pcace/Tailwind/_documentation/3DPrints/readme.md

files from: https://endless-sphere.com/sphere/threads/opensource-ampler.111419/
