pcace/Tailwind/_documentation/Ampler Controller BAC500/Readme.md

The Ampler (at least Curt) uses a BAC-500 esc with a custom daughterboard which handles bluetooth, on/off swiching and 5V BEC
