pcace/Tailwind/_documentation/Arduino/Readme.md

vesc files from https://endless-sphere.com/sphere/threads/opensource-ampler.111419/#post-1712720
