pcace/Tailwind/_documentation/Charging port/Readme.md

the charging port (2018 Ampler Curt) has 6 PIns:

- 2 High Voltage charging pins, directly connected to the Battery BMS.
- GND and +5 Volt directly to Ampler Daughterboard (see readme.md in Ampler Controller BAC500)
- RX and TX to the BAC500 Esc. possibly for maintenance / support / reprogramming (?) see BAC500 for datasheets

Pins from the charging port to BEC500: 

BLUE        PIN20   RS485-TX
YELLOW      PIN19   RS485-RX

STECKER zum AN AUS SCHALTER:
gehen nur auf das ampler daugther board
