pcace/Tailwind/_documentation/TorqueSensor/Torque Sensor.md

The throttle sensor needs >7V to operate the torque sensor. a simple stepup converter does the trick!

Stecker vom Tretlager sensor, kabelfarben: 

ORANGE, leicht bräunlich,   pin14,  "Throttle Sig" (torque)
WEIß^                   ,   pin13,  "+12V"
BRAUN                       Pin9,   "PFS"
GRüN                        pin12,  "CRUISE"
SCHWARZ,                    PIN16,  "GND"
