pcace/Tailwind/_documentation/Ampler Controller BAC500/files/1696029982506.png

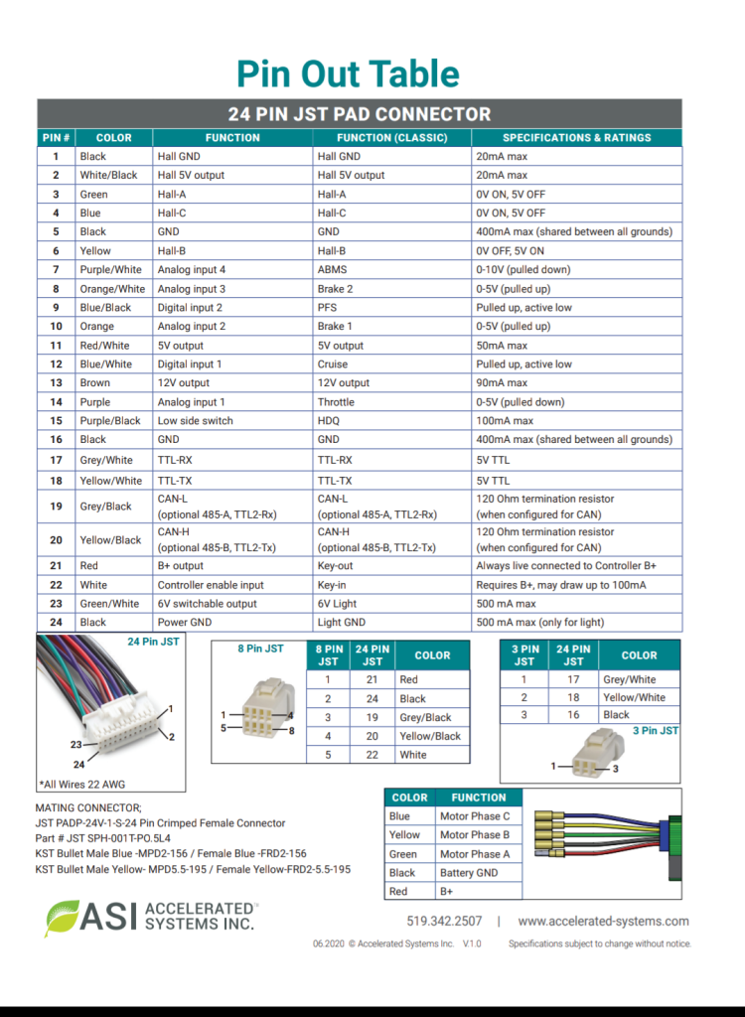
_documentation/Ampler Controller BAC500/files/1696029982506.png
