pcace/Tailwind/_documentation/Ampler Controller BAC500/files/1696030157137.png

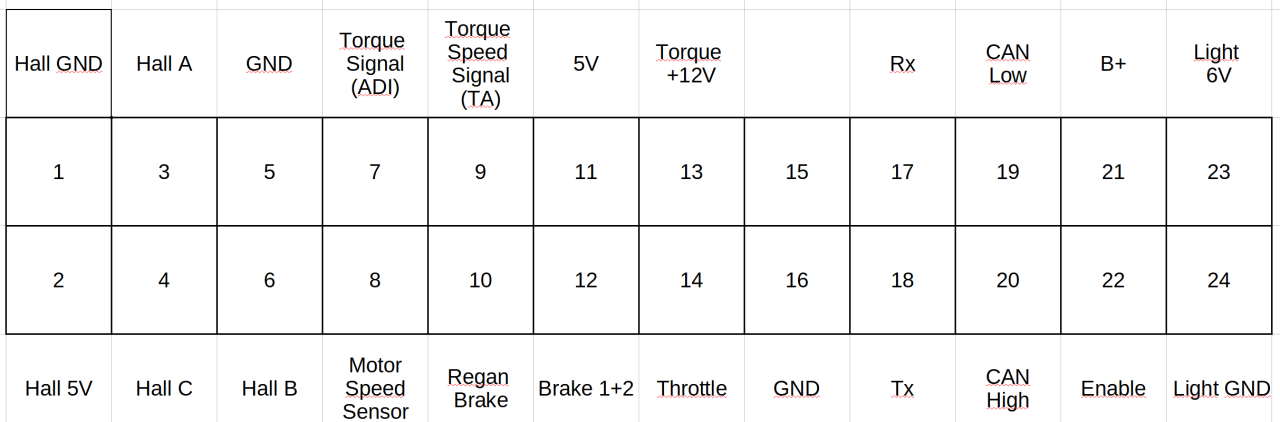
_documentation/Ampler Controller BAC500/files/1696030157137.png
