pcace/Tailwind/_documentation/Ampler Controller BAC500/files/IMG_7743.jpeg

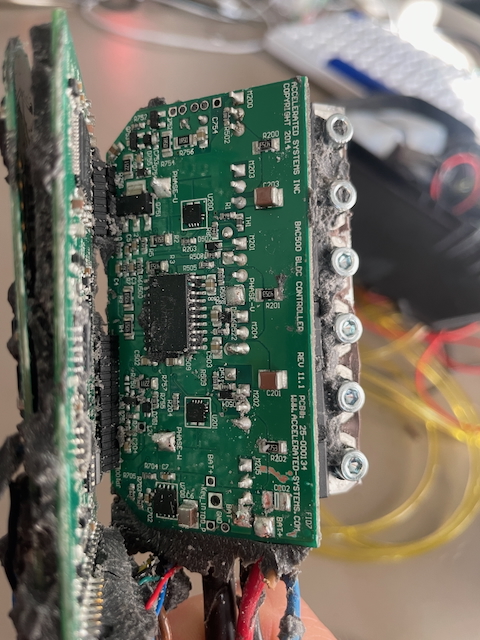
_documentation/Ampler Controller BAC500/files/IMG_7743.jpeg
