pcace/Tailwind/_documentation/Ampler Controller BAC500/files/PXL_20220623_150640996.PORTRAIT.jpg

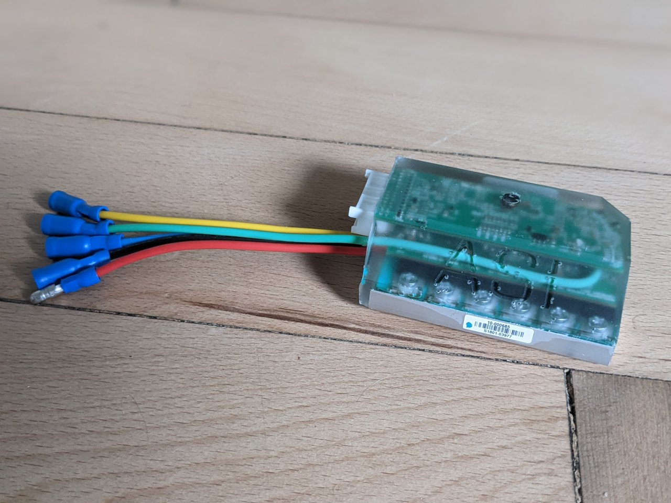
_documentation/Ampler Controller BAC500/files/PXL_20220623_150640996.PORTRAIT.jpg
