pcace/Tailwind/_documentation/Images/configurator-curt-matte-black-belt-0-carrier.jpg

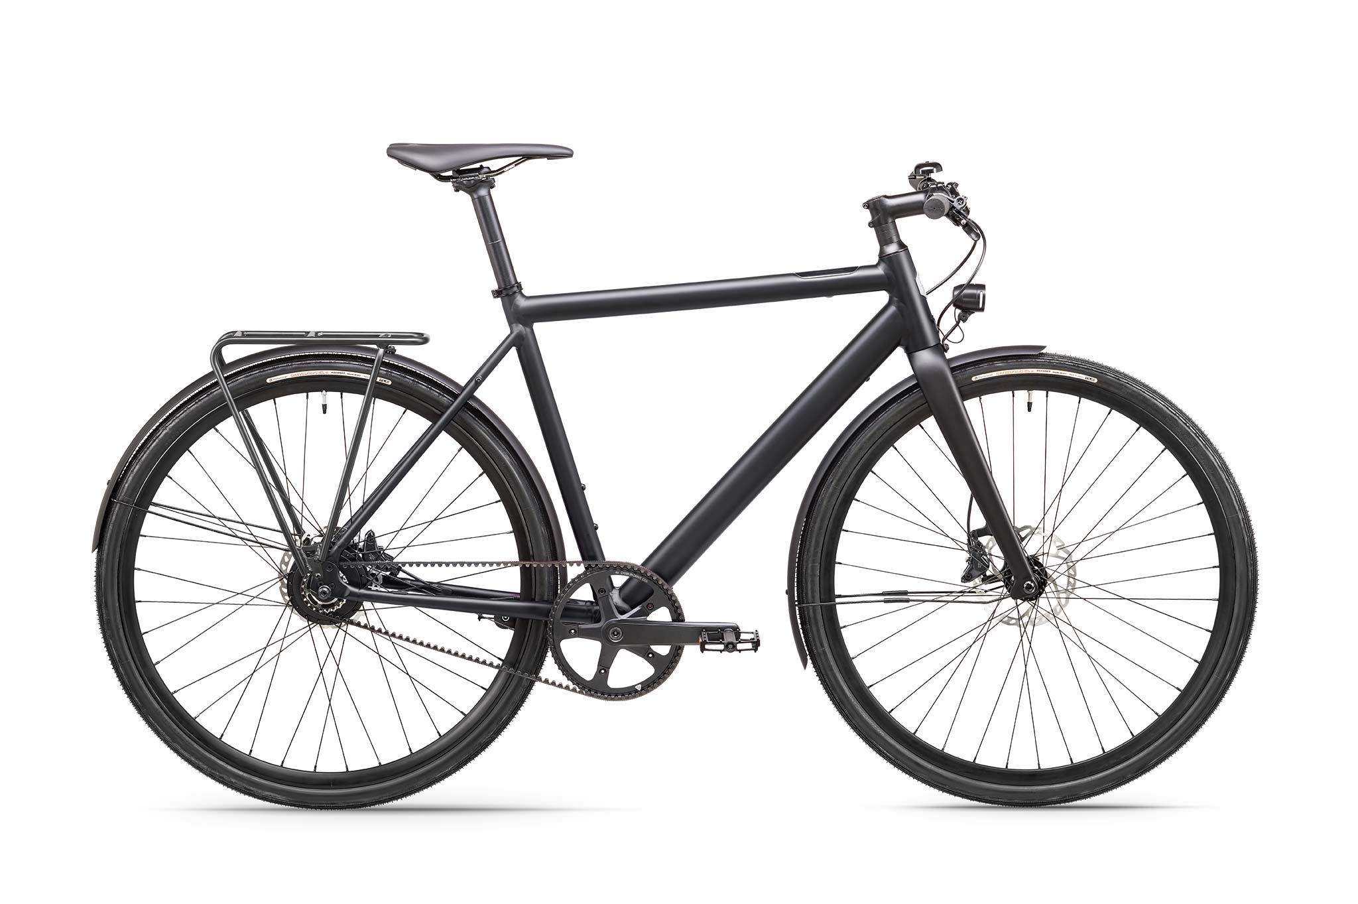
_documentation/Images/configurator-curt-matte-black-belt-0-carrier.jpg
