pcace/Tailwind/_documentation/Motor/files/1/01.jpg

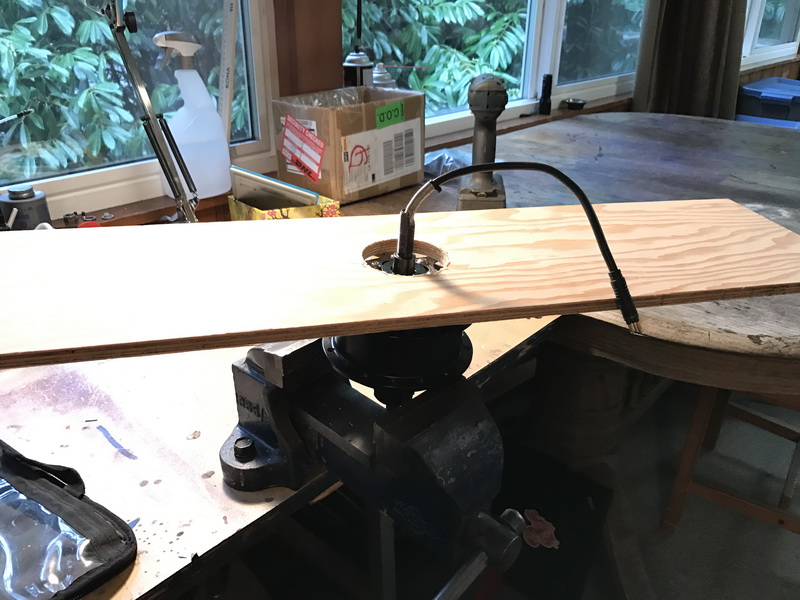
_documentation/Motor/files/1/01.jpg
