pcace/Tailwind/_documentation/Motor/files/1/02.jpg

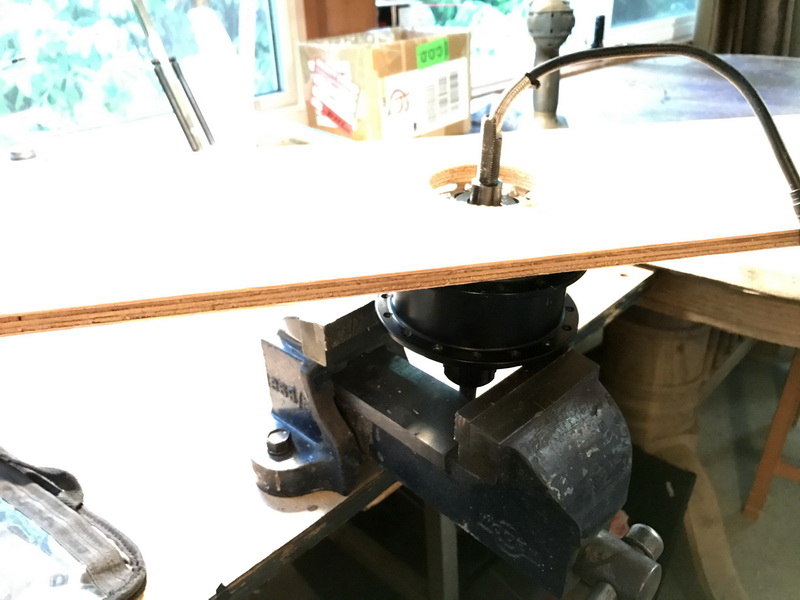
_documentation/Motor/files/1/02.jpg
