pcace/Tailwind/_documentation/Motor/files/1/03.jpg

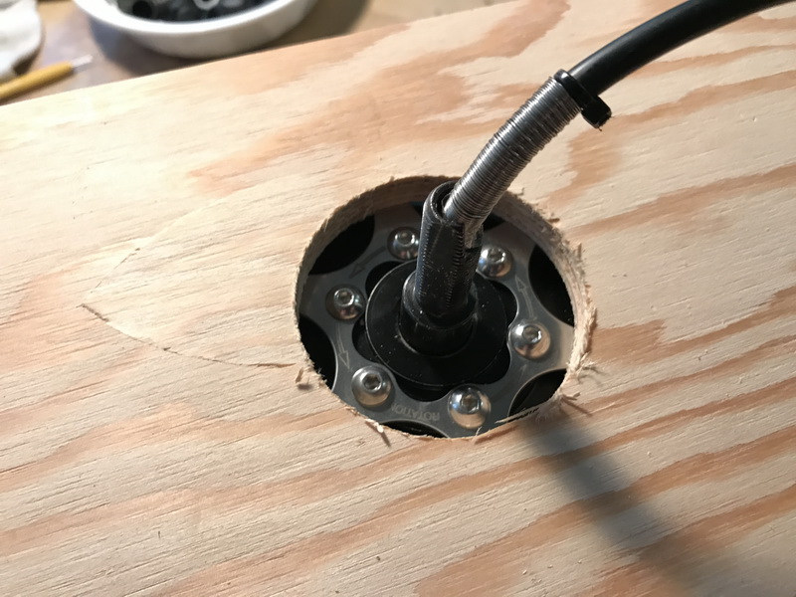
_documentation/Motor/files/1/03.jpg
