pcace/Tailwind/_documentation/Motor/files/1/04.jpg

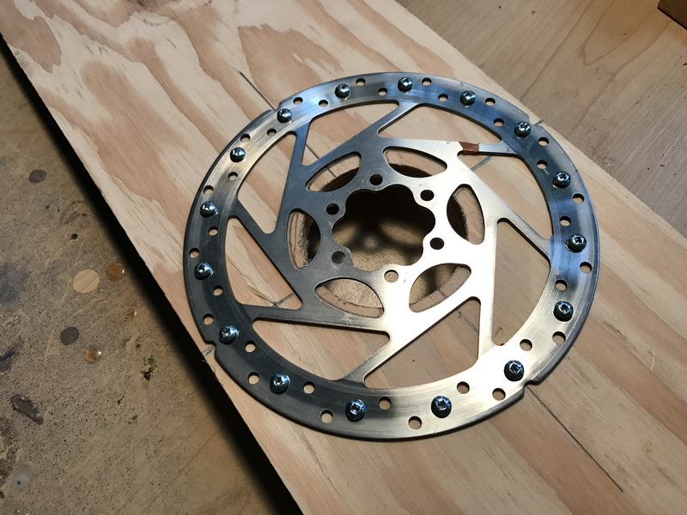
_documentation/Motor/files/1/04.jpg
