pcace/Tailwind/_documentation/Motor/files/1/05.jpg

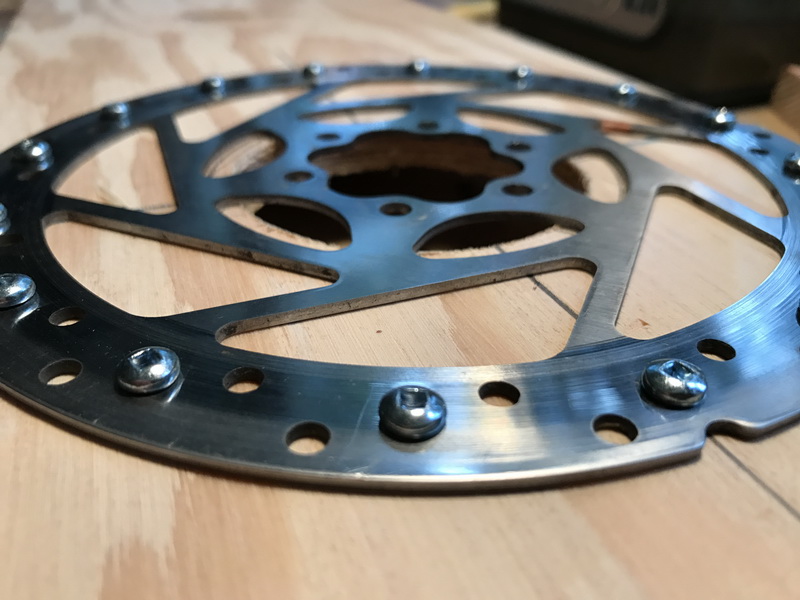
_documentation/Motor/files/1/05.jpg
