pcace/Tailwind/_documentation/Motor/files/1/06.jpg

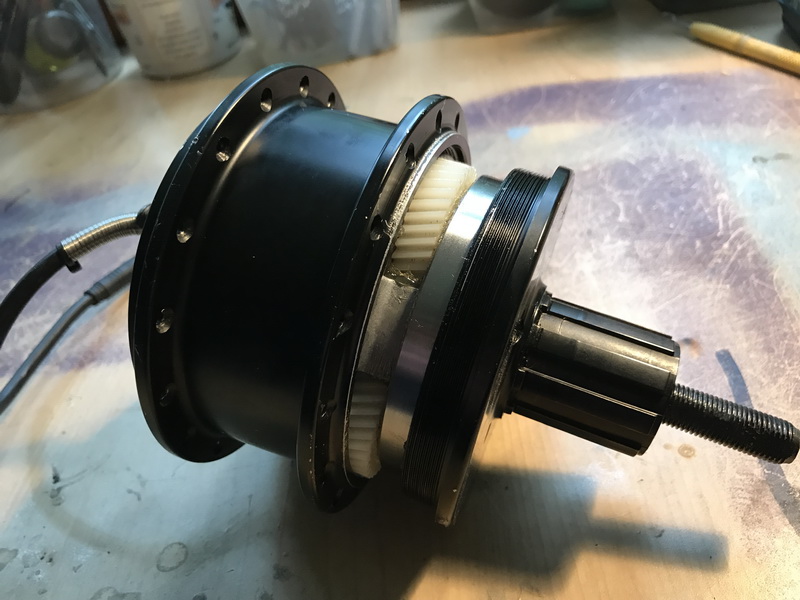
_documentation/Motor/files/1/06.jpg
