pcace/Tailwind/_documentation/Motor/files/1/07.jpg

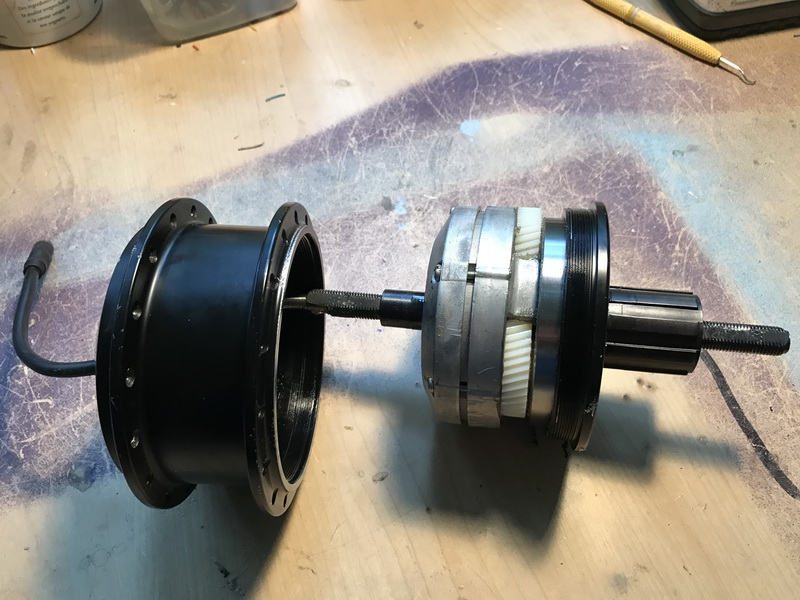
_documentation/Motor/files/1/07.jpg
