pcace/Tailwind/_documentation/Motor/files/1/08.jpg

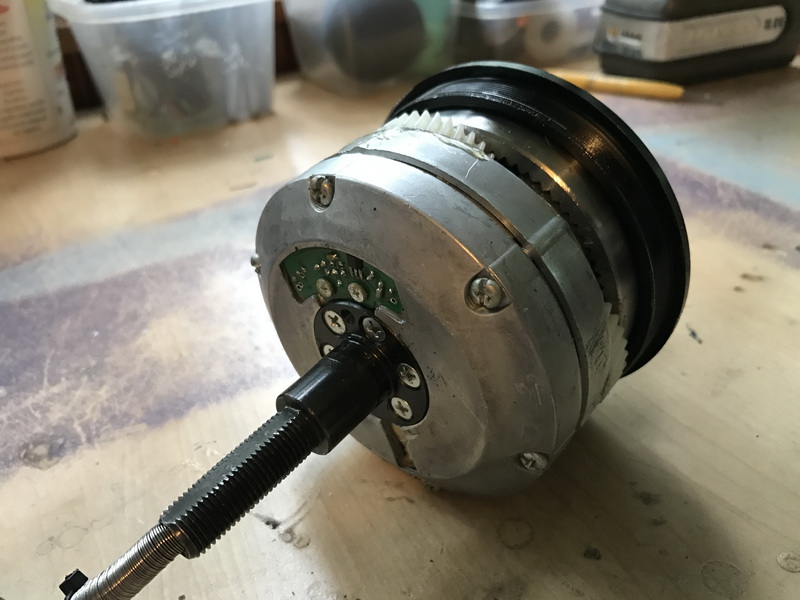
_documentation/Motor/files/1/08.jpg
