pcace/Tailwind/_documentation/Motor/files/1/09.jpg

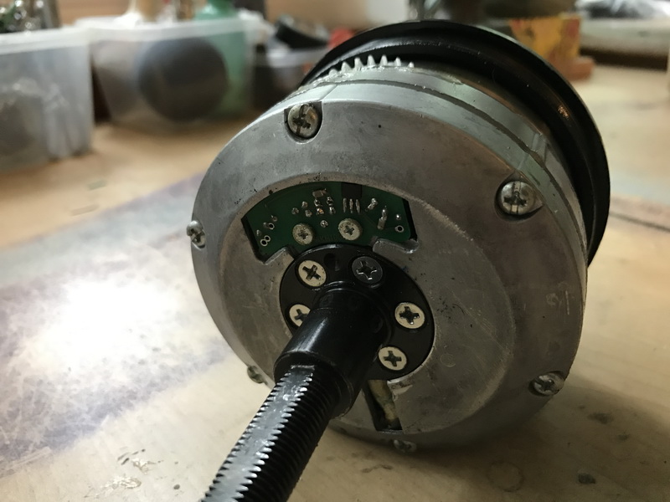
_documentation/Motor/files/1/09.jpg
