pcace/Tailwind/_documentation/Motor/files/1/10.jpg

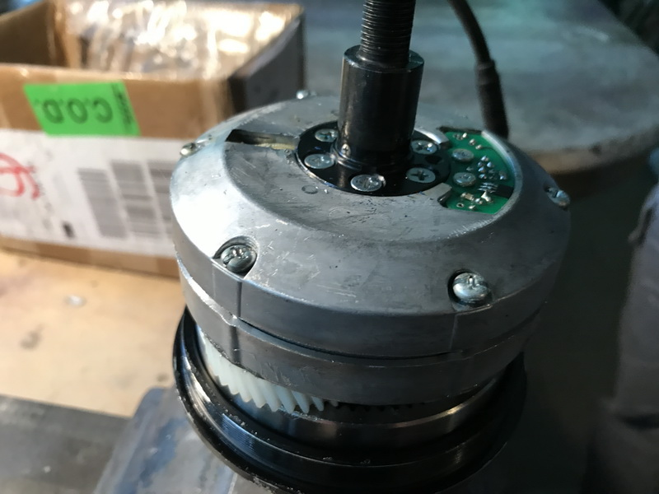
_documentation/Motor/files/1/10.jpg
