pcace/Tailwind/_documentation/Motor/files/1/11.jpg

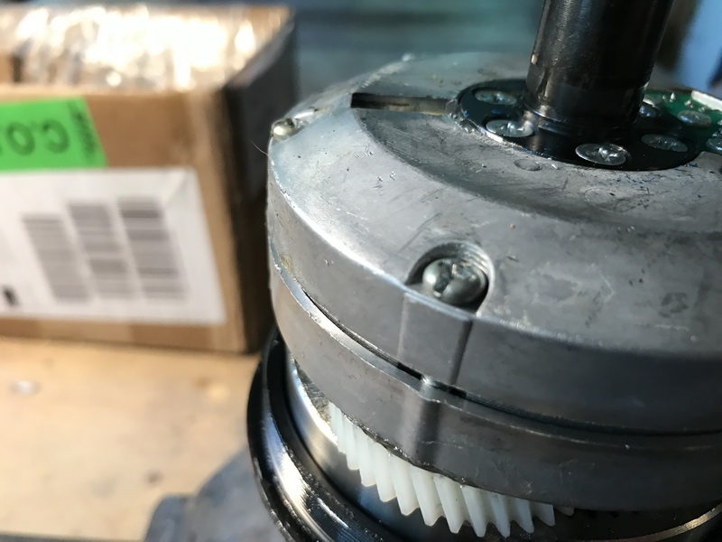
_documentation/Motor/files/1/11.jpg
