pcace/Tailwind/_documentation/Motor/files/1/12.jpg

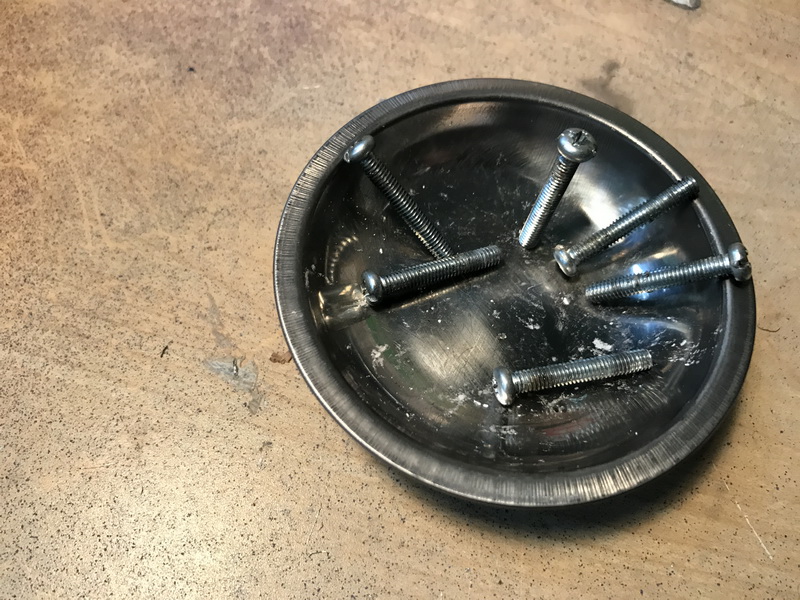
_documentation/Motor/files/1/12.jpg
