pcace/Tailwind/_documentation/Motor/files/1/13.jpg

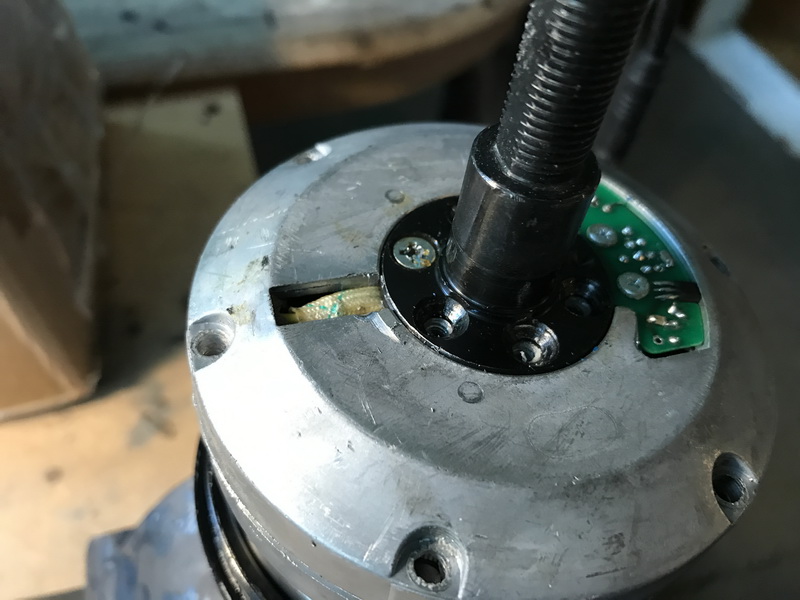
_documentation/Motor/files/1/13.jpg
