pcace/Tailwind/_documentation/Motor/files/1/14.jpg

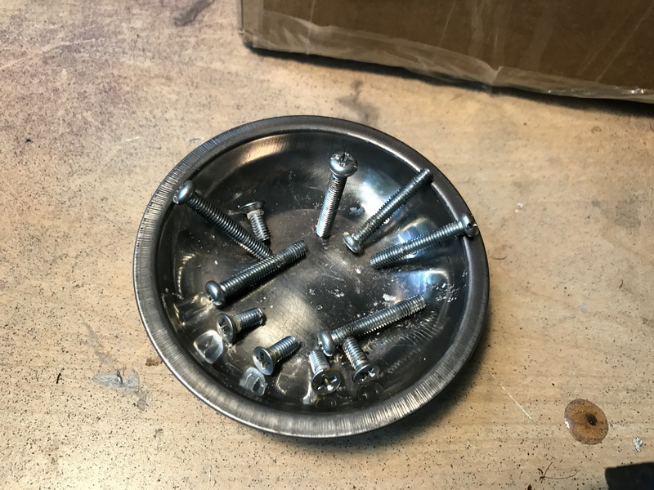
_documentation/Motor/files/1/14.jpg
