pcace/Tailwind/_documentation/Motor/files/1/15-1.jpg

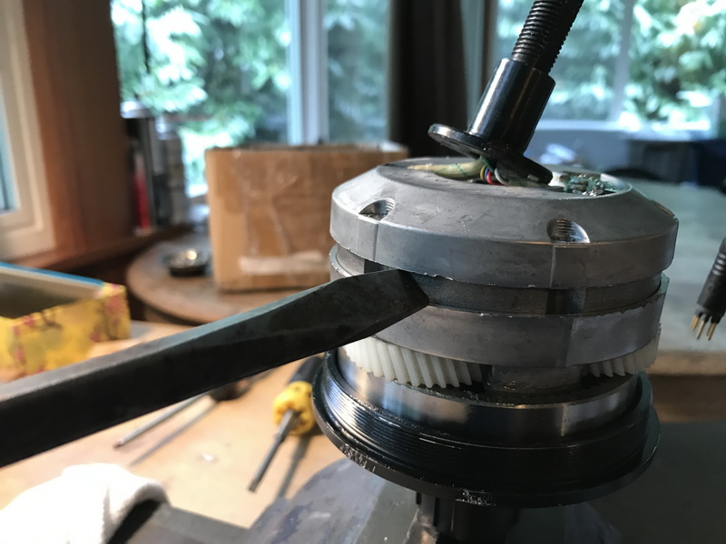
_documentation/Motor/files/1/15-1.jpg
