pcace/Tailwind/_documentation/Motor/files/1/16.jpg

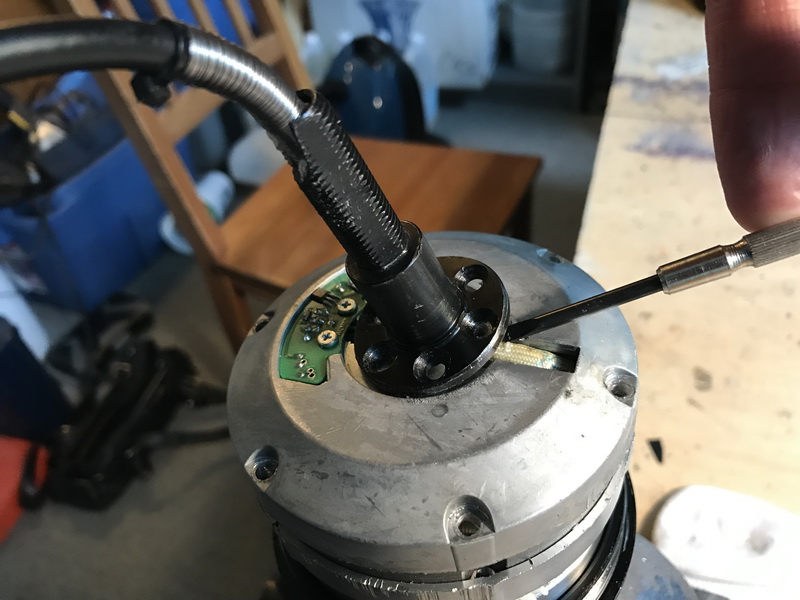
_documentation/Motor/files/1/16.jpg
