pcace/Tailwind/_documentation/Motor/files/1/17.jpg

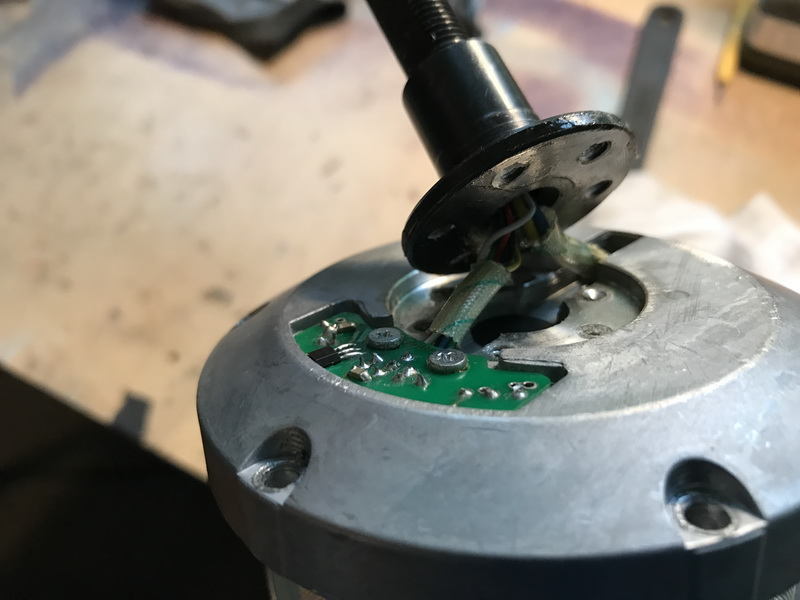
_documentation/Motor/files/1/17.jpg
