pcace/Tailwind/_documentation/Motor/files/1/18.jpg

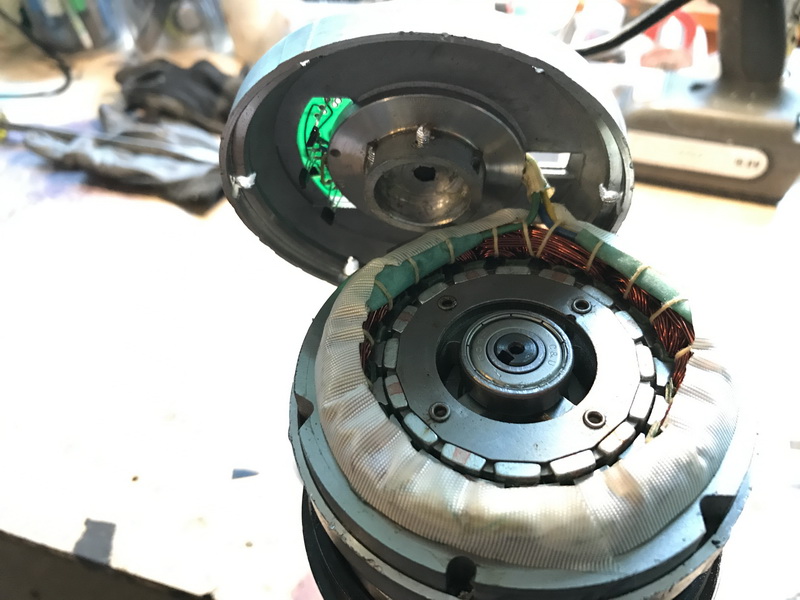
_documentation/Motor/files/1/18.jpg
