pcace/Tailwind/_documentation/Motor/files/1/19.jpg

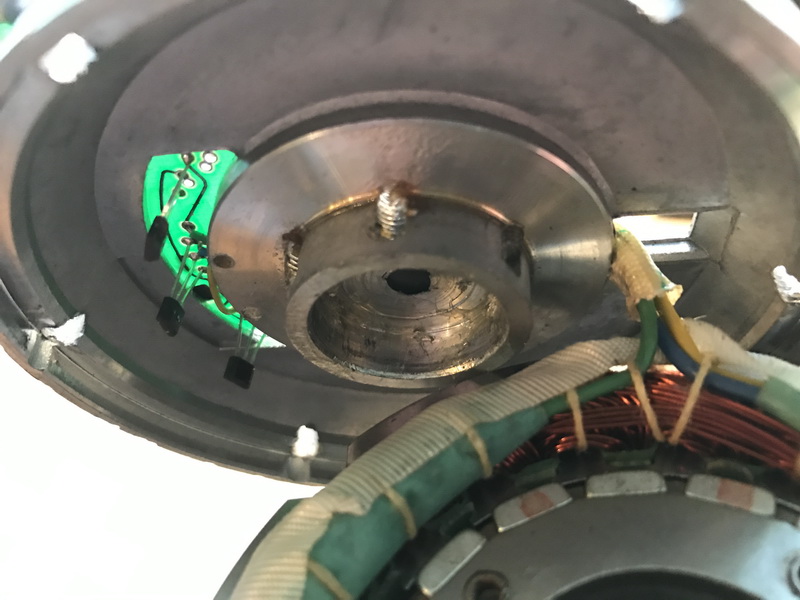
_documentation/Motor/files/1/19.jpg
