pcace/Tailwind/_documentation/Motor/files/1/20.jpg

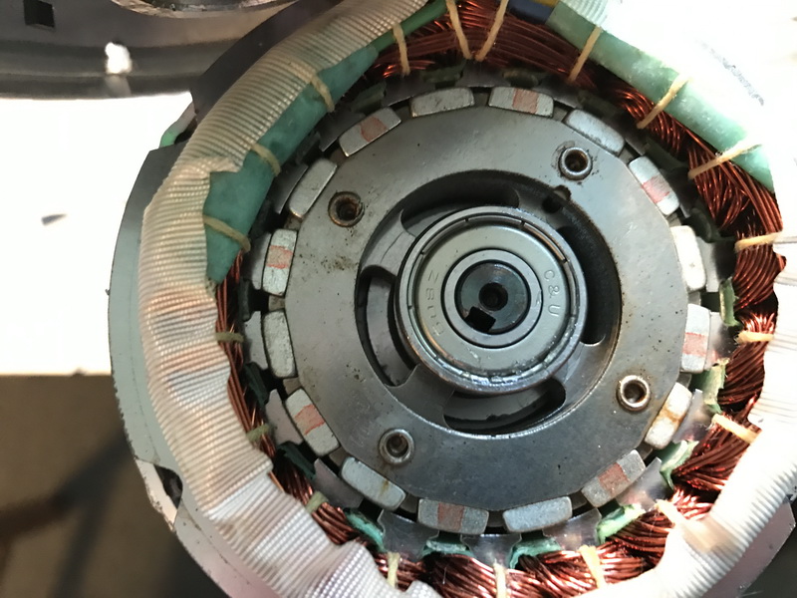
_documentation/Motor/files/1/20.jpg
