pcace/Tailwind/_documentation/webinterface.png

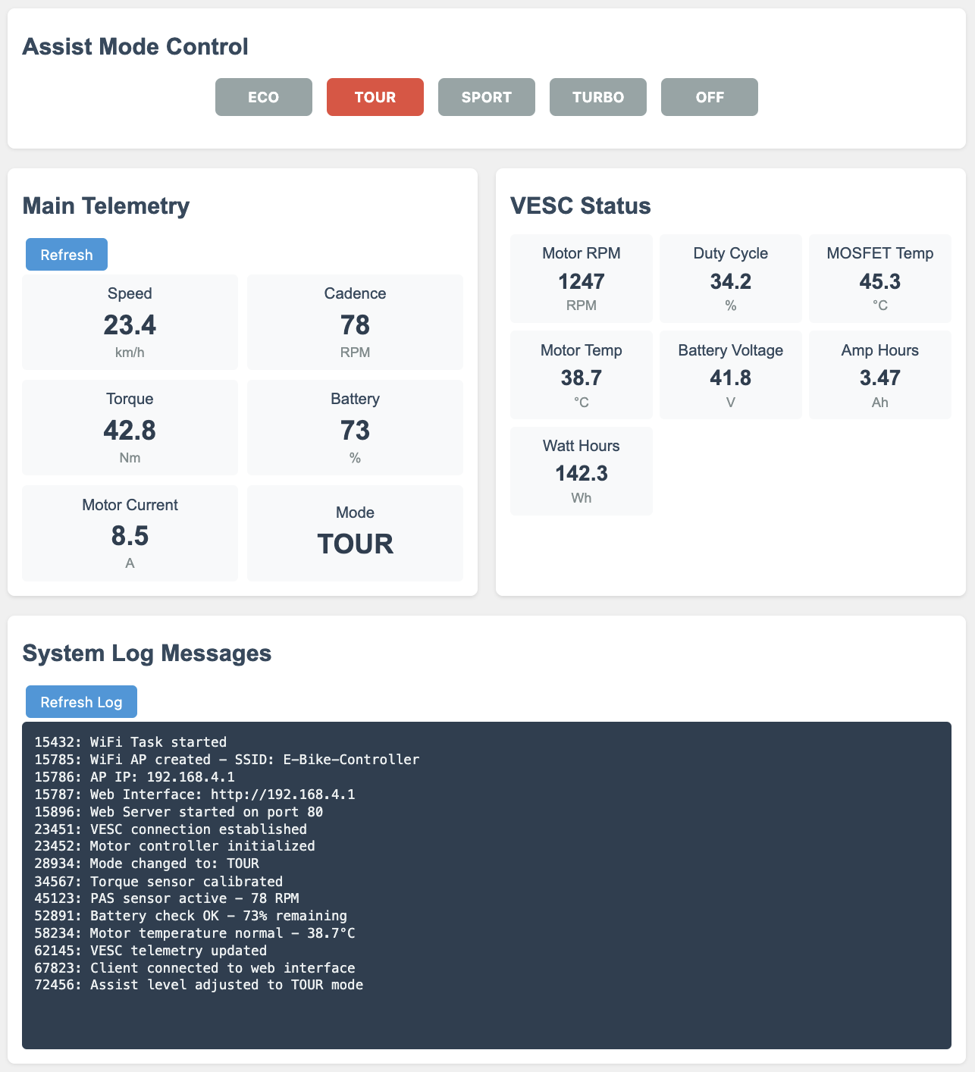
_documentation/webinterface.png
