pcace/Tailwind/_documentation/3DPrints/files/Battery Spacer.stl

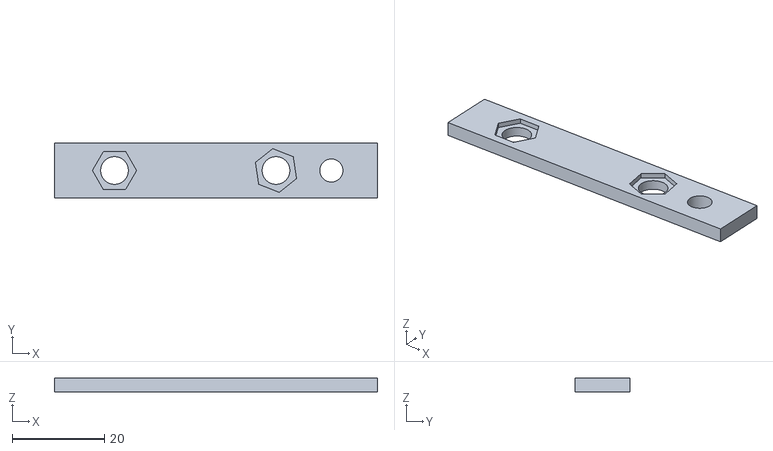
[picture p31: CAD file, 2025-09-08]
_documentation/3DPrints/files/Battery Spacer.stl
70.0 x 12.0 x 3.00
