pcace/Tailwind/_documentation/3DPrints/files/Battery Spacer 2.stl

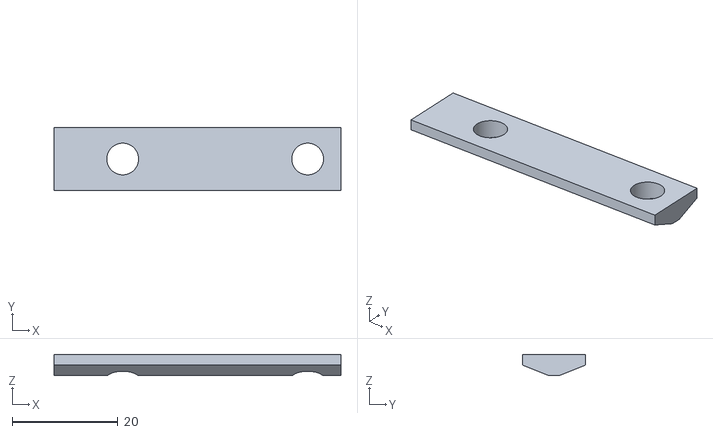
[picture p32: CAD file, 2025-09-08]
_documentation/3DPrints/files/Battery Spacer 2.stl
54.3 x 12.0 x 4.00
