pcace/Tailwind/_documentation/3DPrints/files/Charging Cap.stl

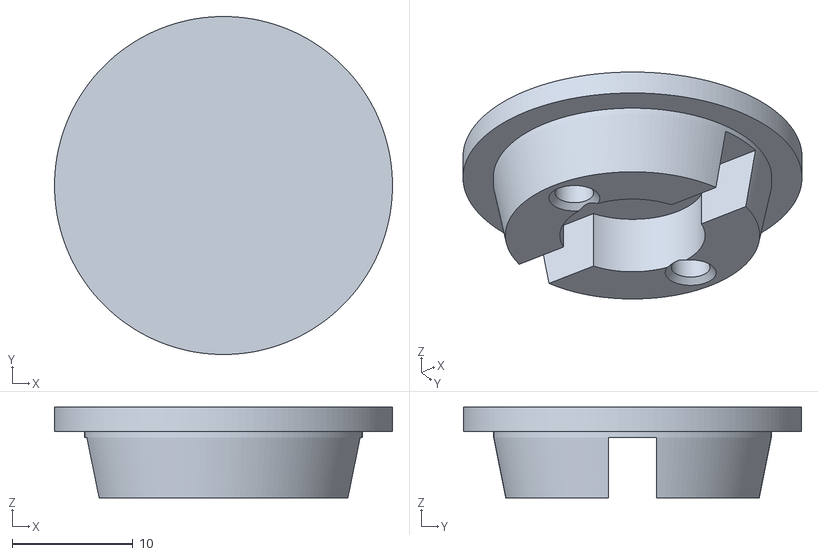
[picture p33: CAD file, 2025-09-08]
_documentation/3DPrints/files/Charging Cap.stl
28.0 x 28.0 x 7.50
