pcace/Tailwind/_documentation/3DPrints/files/Charing Swich Spacer.stl

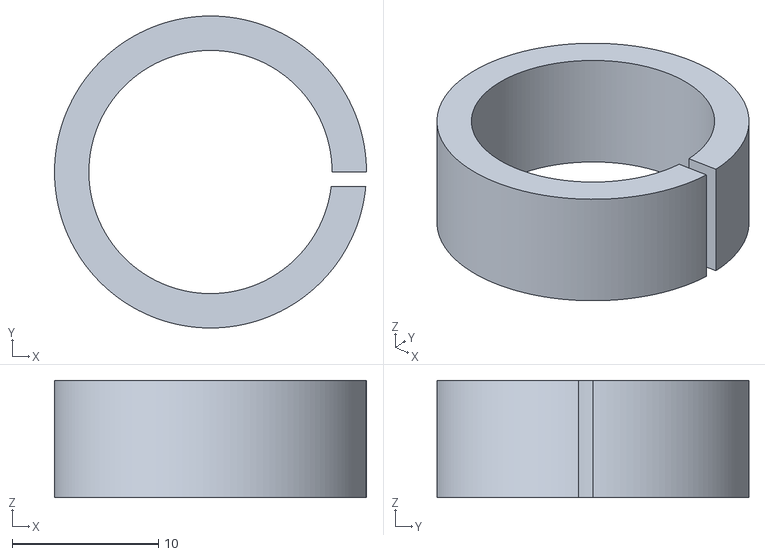
[picture p34: CAD file, 2025-09-08]
_documentation/3DPrints/files/Charing Swich Spacer.stl
21.3 x 21.3 x 8.00
