pcace/Tailwind/_documentation/Motor/files/Q100CST Outline.pdf

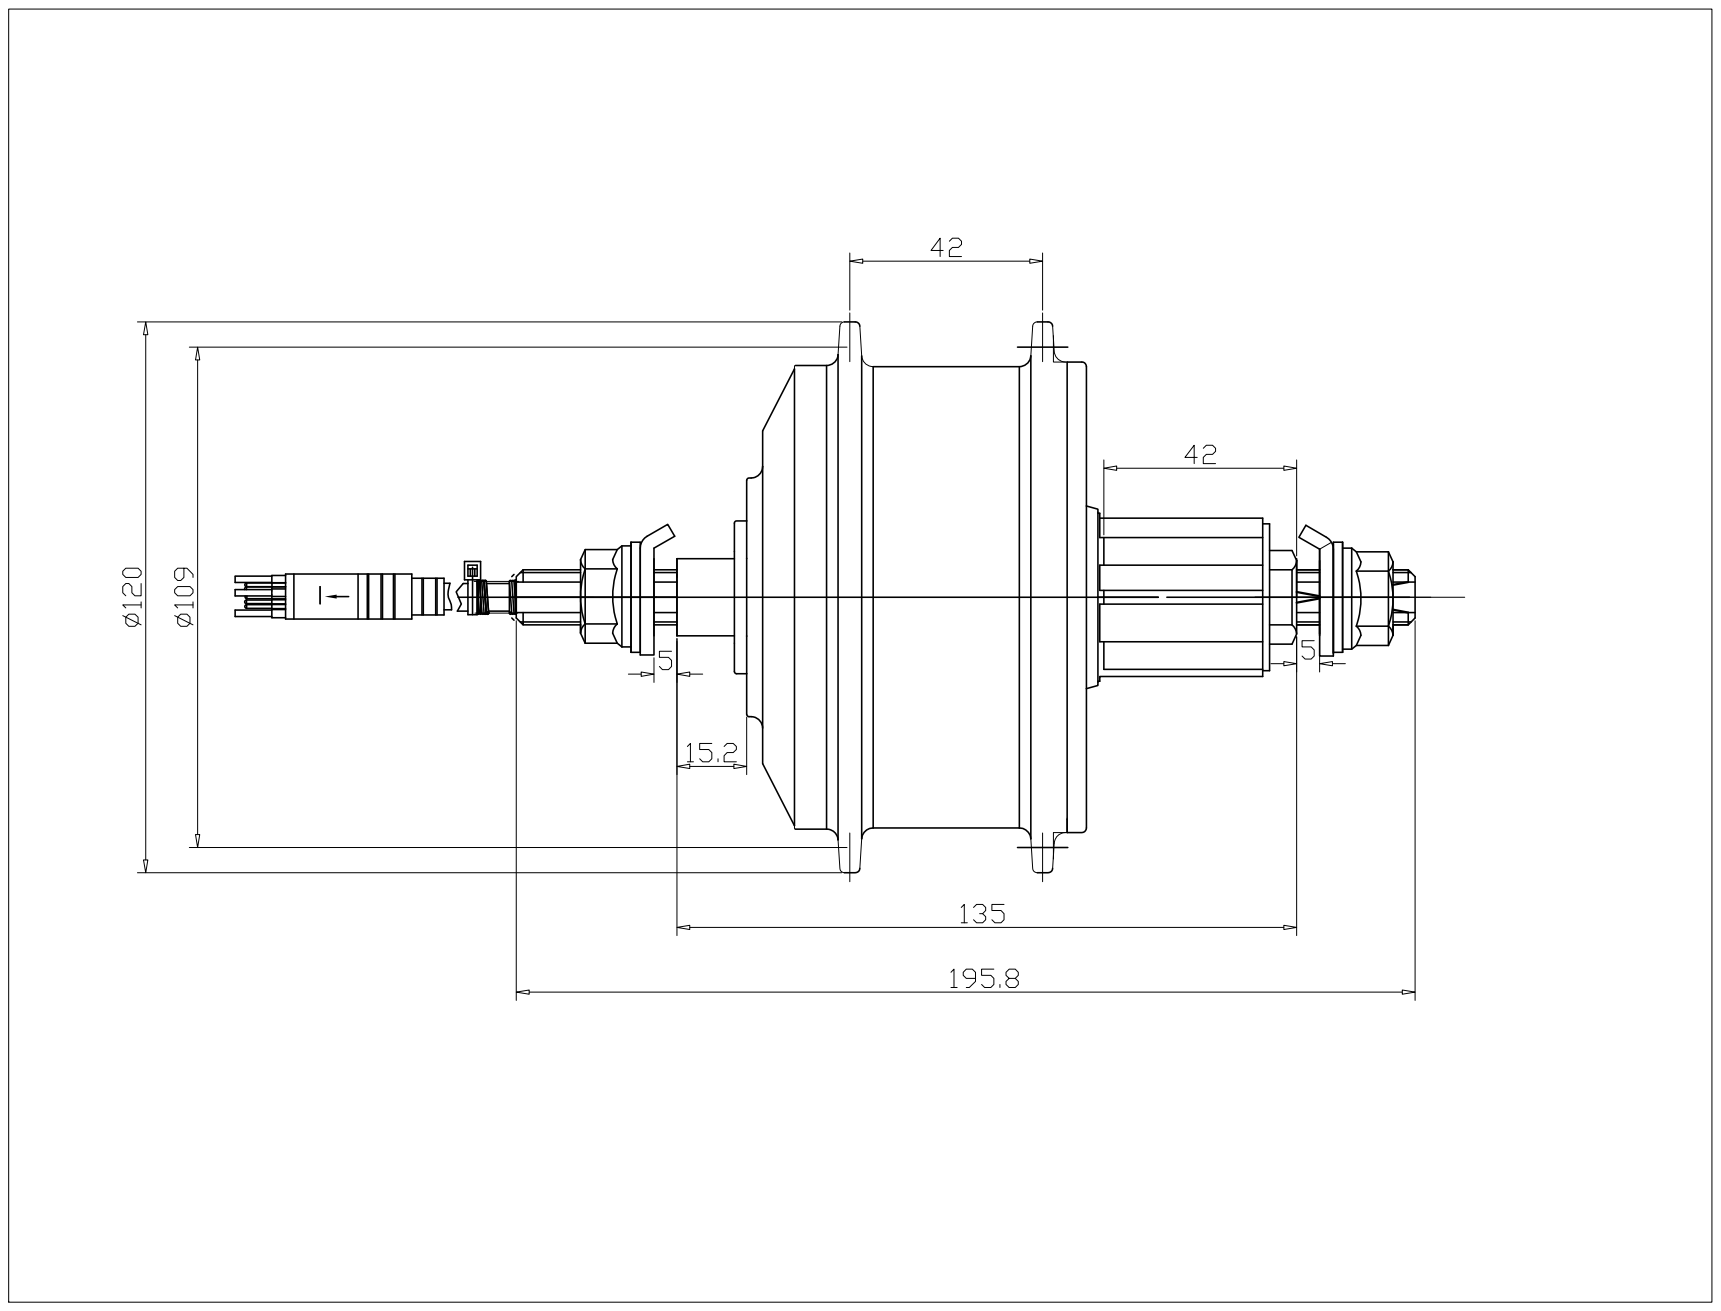
[picture p35: page 1]
