pcace/Tailwind/(commit log)

2025-09-08 feat: :sparkles: init
    [250907vesc_appconf.xml, Battery Spacer 2.stl, Battery Spacer.stl, Charging Cap.stl, Charing Swich Spacer.stl]
2026-03-01 feat: :zap: shows mode change with led flashes
