pcace/Tailwind/_documentation/TorqueSensor/files/IMG_7917.JPEG

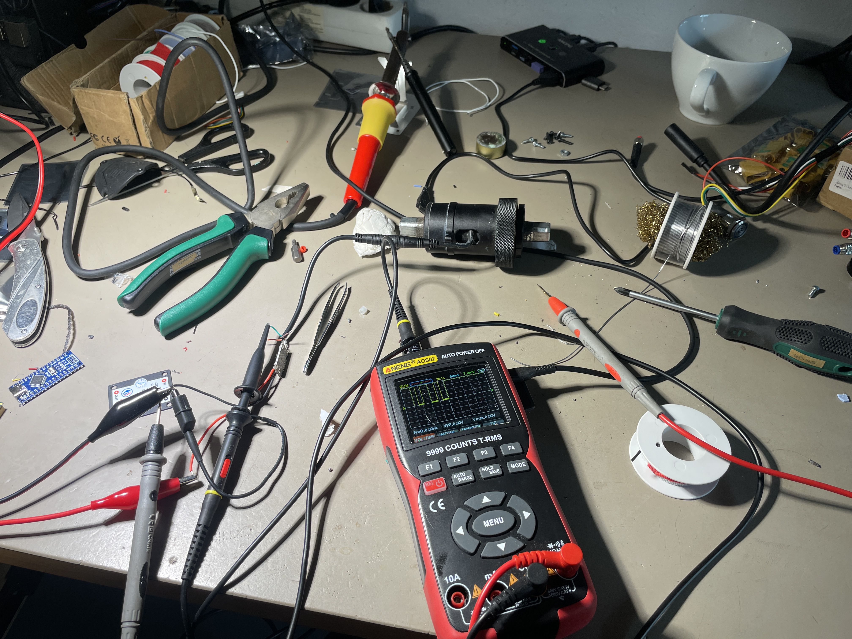
_documentation/TorqueSensor/files/IMG_7917.JPEG
